frexcuadillera/rice-vending-machine/Thesis-CODE/2.png

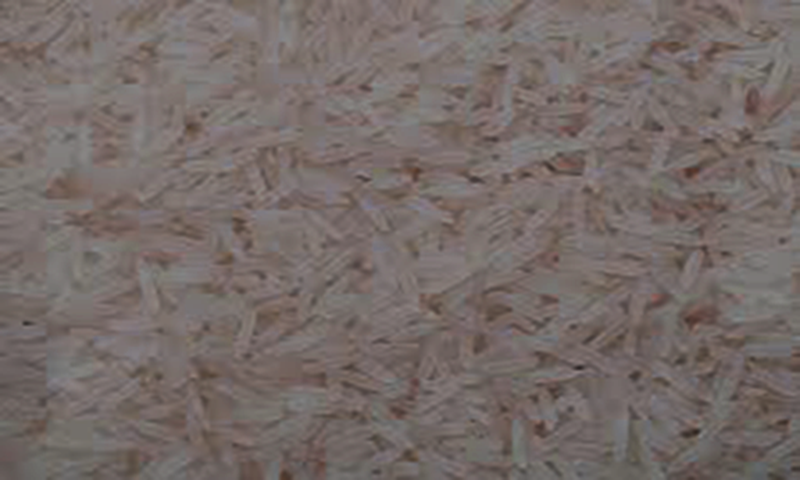
Thesis-CODE/2.png
