frexcuadillera/rice-vending-machine/Thesis-CODE/bg.gif

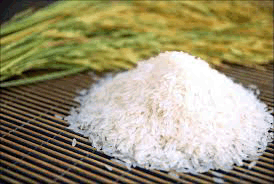
Thesis-CODE/bg.gif
