frexcuadillera/rice-vending-machine/Thesis-CODE/docu1.docx

!/usr/bin/env python

from tkinter import *

from main_screen import *

from Customer import *

from PIL import Image, ImageTk

import os

def main_account_screen():

def shutdown():

os.system("sudo shutdown -h now")

global main_screen

main_screen = Tk()

main_screen.title("Welcome Page")

main_screen.frame

main_screen.attributes("-fullscreen",True)

main_screen.geometry("800x480")

main_screen.resizable(False,False)

load = Image.open("C:\\Users\\Jelmer\\Desktop\\Thesis-CODE\\2.png")

render = ImageTk.PhotoImage(load)

img = Label(main_screen, image=render)

img.image = render

img.place(x=0, y=0)

photo = PhotoImage(file = r"C:\\Users\\Jelmer\\Desktop\\Thesis-CODE\\button1.png")

label=Label (main_screen,text="Automated Rice Vending Machine",bg="chartreuse3", fg="white", font="Sans-serif 30 bold", width=50, pady=10).pack()

label0 = Label (main_screen, background="chartreuse3", width="150", height=7)

label0.place(relx=0, rely= 0.85)

button_admin = Button(main_screen, text = "Administrator", bg="chartreuse3", font="Sans-serif 20 ", width=15,pady=5, command=login)

button_admin.place(relx=0.35, rely=0.2)

button_new_admin = Button(main_screen, text = "New Owner",bg="chartreuse3", font="Sans-serif 20 ", width=15, pady=5, command=register)

button_new_admin.place(relx=0.35, rely=0.4)

button_start = Button(main_screen, text = "Start", bg="chartreuse3", font="Sans-serif 20 ", width=15, pady=5, command=Customer)

button_start.place(relx=0.35, rely=0.6)

button_shutdown = Button(main_screen,image = photo,width=40, height=40,bg="black", command=shutdown)

button_shutdown.place(relx=0.04, rely=0.87)

main_screen.mainloop()

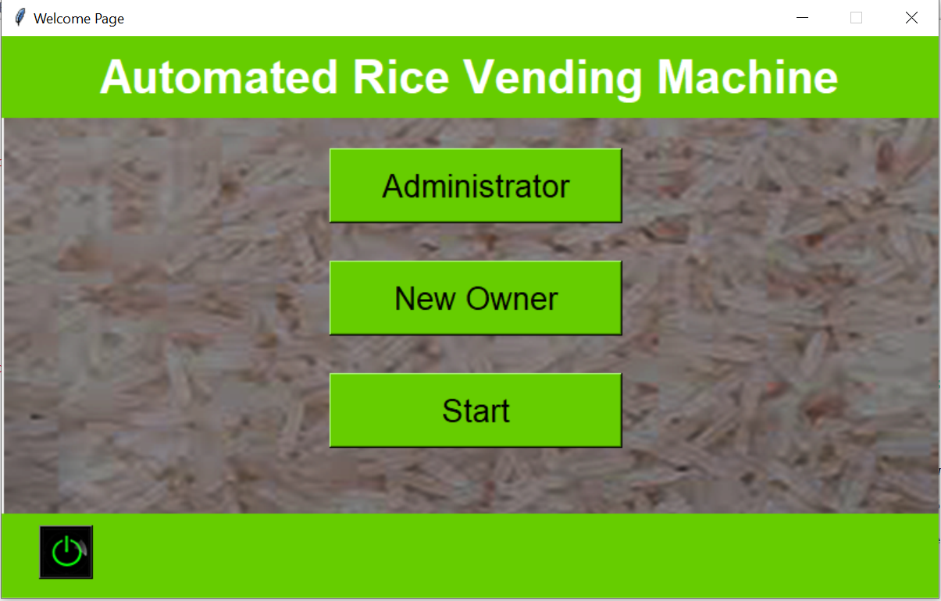
[picture p3: figure]

main_account_screen()

def login():

global login_screen

login_screen = Toplevel()

login_screen.title("Login")

login_screen.geometry("800x480")

labellog=Label(login_screen, text="Please enter details below to login", fg="blue4", bg= "dodger blue", font="Sans-serif 20 bold").pack()

login_screen.configure(background = "dodger blue")

global username_verify

global password_verify

username_verify = StringVar()

password_verify = StringVar()

global username_login_entry

global password_login_entry

labellog1 = Label(login_screen, text="Username ", fg="blue4", bg="dodger blue", font="Sans-serif 15 ")

labellog1.place(relx=0.4, rely=0.27)

username_login_entry = Entry(login_screen, textvariable=username_verify)

username_login_entry.place(relx=0.37, rely=0.38)

labellog2 = Label(login_screen, text="Password ", fg="blue4", bg="dodger blue", font="Sans-serif 15")

labellog2.place(relx=0.4, rely=0.49)

password_login_entry = Entry(login_screen, textvariable=password_verify, show= '*')

password_login_entry.place(relx=0.37, rely=0.6)

button = Button(login_screen, text="Login", bg="gray", width=10, height=1, command = login_verify)

button.place(relx=0.4, rely=0.8)

button = Button(login_screen, text="Cancel", bg="gray", width=10, height=1, command =main_screen_delete )

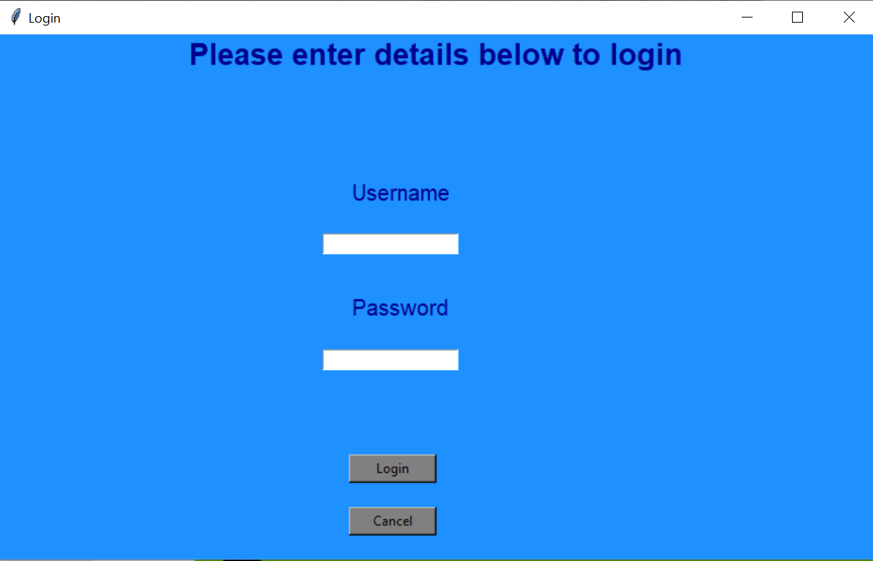
[picture p4: figure]

button.place(relx=0.4, rely=0.9)

def register():

global register_screen

register_screen = Toplevel()

register_screen.title("Register")

register_screen.geometry("800x480")

register_screen.frame

register_screen.resizable(False,False)

load = Image.open("C:\\Users\\Jelmer\\Desktop\\Thesis-CODE\\2.png")

render = ImageTk.PhotoImage(load)

img = Label(register_screen, image=render)

img.image = render

img.place(x=0, y=0)

global username

global password

global username_entry

global password_entry

username = StringVar()

password = StringVar()

labelreg = Label(register_screen, text="Please enter details below", bg="chartreuse3", fg="blue4", width= 50, pady=10, font="Sans-serif 20 bold") .pack()

username_label = Label(register_screen, text="Username",fg="blue4", font="Sans-serif 15",bg="chartreuse3")

username_label.place(relx=0.4, rely=0.3)

username_entry = Entry(register_screen, textvariable=username)

username_entry.place(relx=0.38, rely=0.4)

password_label = Label(register_screen, text="Password", fg="blue4", font="Sans-serif 15 ",bg="chartreuse3")

password_label.place(relx=0.4, rely=0.5)

password_entry = Entry(register_screen, textvariable=password, show='*')

password_entry.place(relx=0.38, rely=0.6)

buttonreg = Button(register_screen, text="Register", width=10, height=1, bg="gray", fg="blue4", font="Sans-serif 10", command = register_user)

buttonreg.place(relx=0.4, rely=0.8)

button = Button(register_screen, text="Cancel", bg="gray",fg="blue4",font="Sans-serif 10", width=10, height=1, command =register_screen_delete )

button.place(relx=0.4, rely=0.9)

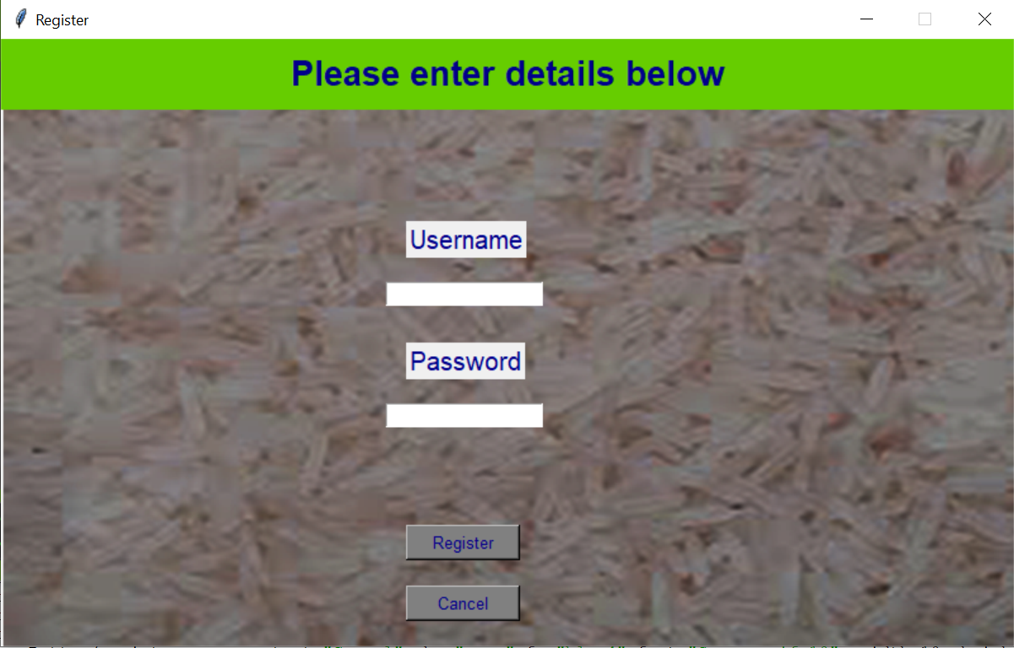
[picture p5: figure]
