frexcuadillera/rice-vending-machine/Thesis-CODE/welcome page.docx

#!/usr/bin/env python

from tkinter import *

from main_screen import *

from Customer import *

import os

def main_account_screen():

global main_screen

main_screen = Tk()

main_screen.title("Welcome Page")

main_screen.frame

main_screen.geometry("576x317")

main_screen.resizable(False,False)

#para magkakulay yung buong window

# main_screen.configure(background="dodger blue")

background = Canvas(main_screen, height=500, width=500)

filename = PhotoImage(file = "C:\\Users\\Jelmer\\Desktop\\Thesis-CODE\\2.png")

background_label = Label(main_screen, image=filename)

background_label.place(x=0, y=0, relwidth=1, relheight=1)

#label

label=Label (main_screen,text="Automated Rice Vending Machine",bg="chartreuse3", fg="white", font="Sans-serif 20 bold", width=35, pady=5).pack()

button_admin = Button(main_screen, text = "Administrator", bg="chartreuse3", font="Sans-serif 15 ", width=12, command=login)

button_admin.place(relx=0.35, rely=0.2)

button_new_admin = Button(main_screen, text = "New Owner",bg="chartreuse3", font="Sans-serif 15 ", width=12, command=register)

button_new_admin.place(relx=0.35, rely=0.4)

button_start = Button(main_screen, text = "Start", bg="chartreuse3", font="Sans-serif 15 ", width=12, command=Customer)

button_start.place(relx=0.35, rely=0.6)

main_screen.mainloop()

main_account_screen()

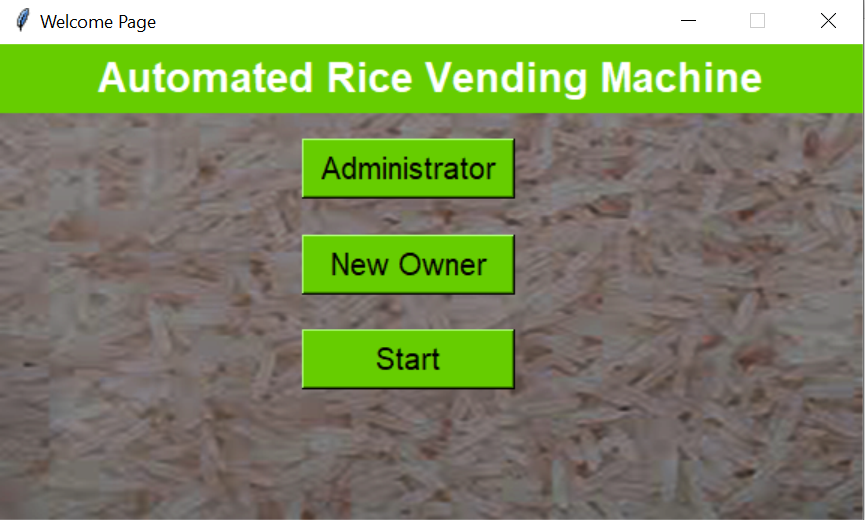
[picture p6: figure]
