frexcuadillera/rice-vending-machine/SERVO/360 servo table.PNG

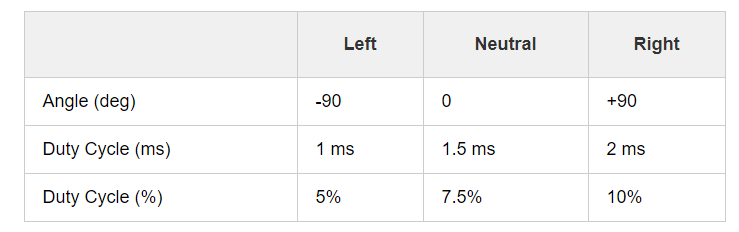
SERVO/360 servo table.PNG
