frexcuadillera/rice-vending-machine/Thesis-CODE/key1.png

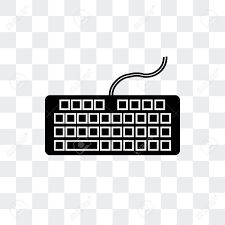
Thesis-CODE/key1.png
