frexcuadillera/rice-vending-machine/Thesis-CODE/key.png

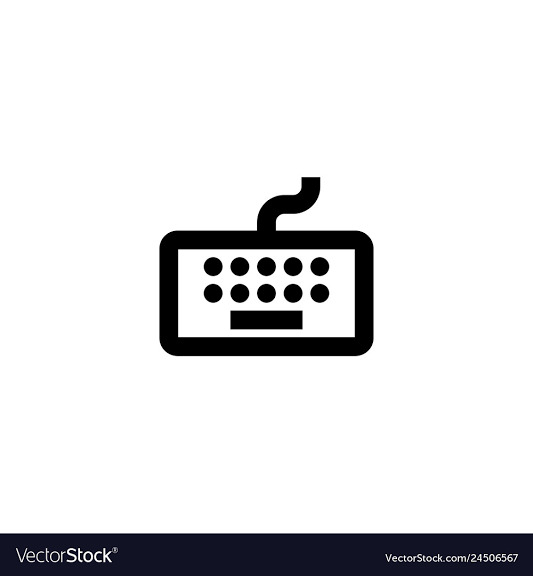
Thesis-CODE/key.png
